hildlabs/gba-rig/(commit log)

2026-11-04 GBA shiny hunting rig: Arduino sketch, wiring and photos
2026-11-04 Store reset counter as uint16_t and handle blank EEPROM
    A fresh EEPROM reads 0xFFFF, which showed up as -1 on the LCD, and the
    signed int counter wrapped to negative values after 32767 resets.
    Fixes #1
    [shiny_hunter.ino]
